ymirmeddeb/MazeRunnerBot/README.md

# MazeRunnerBot

## Abstract
The MazeRunnerBot project is a robotic application designed to autonomously navigate through mazes. Utilizing a combination of sensor inputs and programmed logic, the robot detects and maneuvers around obstacles, aiming for the most efficient path to the exit. A more detailed description of the robot's functionnality is in the [MazeRunnerBot_report.pdf](https://github.com/ymirmeddeb/MazeRunnerBot/blob/main/docs/MazeRunnerBot_report.pdf) file present in this repository.

## Introduction
As part of the Computer Engineering curriculum at the National University of Singapore, this project challenges students to apply principles of robotics, computer vision, and algorithmic problem-solving in a practical, hands-on manner.

## Hardware
The robot is built using the following components:
- Mainboard: Arduino Uno
- Motors: 2x DC Motors with wheels
- Sensors: Ultrasonic distance sensor, line-following sensor, colour sensor
- Power: 6V battery pack

## Software
The software controlling the MazeRunnerBot is written in C++ for Arduino. The main features include obstacle detection, path planning, and motor control. The source code is provided in the `code` directory within this repository.

## Algorithm Overview
The MazeRunnerBot uses a simple yet effective algorithm to navigate mazes:
- Forward motion until an obstacle is detected.
- When an obstacle is encountered, the colour sensor under the robot detects the colour.
- A decision-making process based on the sensor readings is put in motion.

## Challenges & Solutions
Throughout the project, we faced challenges such as sensor noise and motor power inconsistencies. These were mitigated through calibration procedures and software filters, enhancing the robot's reliability.

## Conclusion
The MazeRunnerBot successfully met the project's objectives by demonstrating its ability to navigate mazes without human intervention.

## Acknowledgements
Special thanks to our project supervisor and the NUS College of Design and Engineering for providing resources and support.

## Pictures of the robot
